gauteh/omb-nano/(threads)

Thread 1 (2024-05-23):

GPS: power off on EINT

gauteh, 2024-05-23:
* https://github.com/sparkfun/SparkFun_u-blox_GNSS_Arduino_Library/blob/main/examples/Example22_PowerOff/Example22_PowerOff.ino
* https://learn.sparkfun.com/tutorials/gnss-receiver-breakout---max-m10s-qwiic-hookup-guide

gauteh, 2024-08-06:
I'm seeing around 24 mA @ 5V when logging IMU. Seems a bit high to me? I guess I will see the low when the IMU is done sampling and it goes to sleep, would be helpful if the IMU sample window could be decreased to e.g. 30 seconds for in the test-mode.

gauteh, 2024-08-06:
```
content: 0x47 | 0x1 | 0x46 | 0x5E | 0x16 | 0xB2 | 0x66 | 0xAB | 0xCF | 0xFD | 0x23 | 0x8E | 0x83 | 0x2D | 0x3 | 0x45 |
Rock7 format content: 4701465E16B266ABCFFD238E832D0345
--------------------
turn gnss off
putting gps to sleep.
Attempting to put gps to sleep
gnss wire started
success starting GNSS
gps sleeping...
gps sleeping.
success.
turn iridium on
turn gnss off
putting gps to sleep.
Attempting to put gps to sleep
gnss wire started
success starting GNSS
gps sleeping...
gps sleeping.
success.
Calling internalBegin
IridiumSBD::beginSerialPort
>> AT
Waiting for response OK

```

gauteh, 2024-08-06:
Yes, that is what I'm trying to get them to do :)

gauteh, 2024-08-06:
Pretty sure it's the GPS, because unplugging the LiIon on the rockblock does not change the current draw.

gauteh, 2024-08-06:
Relevant code is here: https://github.com/gauteh/omb-2024-nano/blob/main/src/gnss_manager.cpp#L7

gauteh, 2024-08-06:
> the change is to hard code taking just a few imu measurements:
>
> https://github.com/jerabaul29/OpenMetBuoy-v2021a/blob/129916e1e05f97facc37a9b5c94781a2f2e4fec0/legacy_firmware/firmware/functionality_test_mode/wave_analyzer.cpp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

Thanks, I have to do this, since lots of ports and pins are changed from original OMB.

gauteh, 2024-08-06:
Can't unplug the GNSS, its mounted on board.

gauteh, 2024-08-06:
Are the measurements above with the power led on?

gauteh, 2024-08-06:
I think that will destroy the board, I should probably just try this: https://github.com/sparkfun/SparkFun_u-blox_GNSS_Arduino_Library/blob/main/examples/Example22_PowerOff/Example22_PowerOff.ino

gauteh, 2024-08-06:
Yes, good point. I can remove the Artemis to test that. There are also some broken artemises, that use much more power.

gauteh, 2024-08-07:
https://github.com/sparkfun/SparkFun_u-blox_GNSS_Arduino_Library/issues/228

gauteh, 2024-08-28:
If this dosen't work we need to add some on/off circuit.

gauteh, 2024-08-29:
Maybe @zerblatt007 has the chance to help us set up the MOSFET circuit, here's the schematic from SparkFun: https://cdn.sparkfun.com/assets/f/4/5/3/4/SparkFun_Artemis_Global_Tracker_SCHEMATIC_v10.pdf ?

zerblatt007, 2024-08-30:
GPS power switch should be easy enough.. :)

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

zerblatt007, 2024-08-30:
I have inserted the Q1 FET on A16 and updated the PCB, just to see how
things pan out.
This is just more or less dumped on there, so check if it looks ok to you..
There was a new R5 also? And an extra BAT2 ..

fre. 30. aug. 2024 kl. 08:43 skrev Roger Storvik ***@***.***>:

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

gauteh, 2024-08-30:
Nice. Adding the artemis module directly (with USB to serial) would be next on the wishlist ! (should have a JTAG header holes just in case as well).

Closed 2025-03-05.

Thread 8 (2024-05-27):

IMU: power down

gauteh, 2024-05-27:
Is it necessary: what is the current when it is just running?

gauteh, 2024-08-06:
AD31 (A5 on nano) does not seem to be able to drive the power on the IMU, if I short the backup it works. @jerabaul29 do you know how to change the drive-strength in arduino-C?

gauteh, 2024-08-06:
Figured it out:
```

pinMode(IMUPwr, g_AM_HAL_GPIO_OUTPUT_12); // 12 mA

```

gauteh, 2024-08-06:
Yup. Increasing to 12 mA (https://github.com/gauteh/omb-2024-nano/issues/8#issuecomment-2271118244) fixed it. Now trying to put the GNSS to sleep (#1).

Closed 2024-08-06.

Thread 9 (2024-05-29):

points from the discussion

jerabaul29, 2024-05-29:
Thanks for the good discussion @gauteh @askbreivik , and very nice to meet you digitally @askbreivik :) .

The modem you use now is the same I had on:

https://github.com/jerabaul29/LoggerWavesInIce_InSituWithIridium

The PCB schematics are at:

https://github.com/jerabaul29/LoggerWavesInIce_InSituWithIridium/tree/master/PCB_electronics/Logger_and_power_v1

I do not remember how I was giving power to the iridium modem, I wonder if I was just using the 3.3V from the arduino mega, but I may be remembering wrong. The answer should be in the [Logger_and_Power.sch](https://github.com/jerabaul29/LoggerWavesInIce_InSituWithIridium/blob/master/PCB_electronics/Logger_and_power_v1/Logger_and_Power.sch) file (that can be opened with kicad).

Very interesting discussions about power supplies. It may be that my method of having batteries in parallel is a bit suboptimal when using these nice pololu regulators, and that it would be better to put cells in series to get to for example 8-10ish volts, and then use the pololu in step down mode - this looks like this could be more energy efficient and possible to supply more power as you pointed out. Maybe in this case the 3.3V regulator is enough, but as we have discussed it should be easy to put a 5v regulator, and to reduce quiescent current when not in use to switch it off fully with the shdn pin ( https://www.pololu.com/product/2123 ) .

Note that pololu has many regulators, including "old" designs that are much worse than the newer S7V8 series (guess they keep them to supply existing designs :) ), but these more recent S7V8FX regulators are really good :) .

Apololgies for the mess in the OMB code, I have never had the time to clean this up. Let me know if you have any questions. I think that given that the MCU and components are the same, it should be easy to adapt the OMB firmware, with just a few pin number / port number updates as we discussed :) . For the I2C / "Wire" in SF lingua ports, see for example https://github.com/sparkfun/Arduino_Apollo3/blob/v1/libraries/Wire/examples/Example2_MoreI2CPorts/Example2_MoreI2CPorts.ino and adjacent files.

This will be very exciting, looking forward to see how you develop this forward :) .

gauteh, 2025-03-05:
I think we got through most of this. Will continue in separate issues.

Closed 2025-03-05.

Thread 13 (2024-07-29):

Next PCB

gauteh, 2024-07-29:
- [x] Correct space between pins for RockBlock
- [x] More parallel battery-terminals
- [x] Use ambiq module
- [x] transistor for toggling GPS power (@zerblatt007 ) (#1 )
- [x] usb to serial for ambiq module
- [x] pull-down resistor for iridium-off (#14 )

zerblatt007, 2024-09-10:
Do we have any preference on usb to serial chip (for ambiq module)?

tir. 10. sep. 2024 kl. 13:08 skrev Gaute Hope ***@***.***>:

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

zerblatt007, 2024-09-10:
Makes sense to use that one, yes..

Roger

tir. 10. sep. 2024 kl. 15:45 skrev Gaute Hope ***@***.***>:

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

zerblatt007, 2024-10-25:
Have most of this in schematics form now..
We want the fuse and perhaps a regulator?
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

zerblatt007, 2024-10-25:
Do we need something like this?
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

zerblatt007, 2024-10-25:
My reference is this, but maybe not a good one?
https://cdn.sparkfun.com/assets/5/5/1/6/3/RedBoard-Artemis-Nano.pdf

gauteh, 2024-10-25:
Can we use the pololu regulator that we already have on? We know it works with the modem, and it takes a range from about 2.5V to 11.5V?

zerblatt007, 2024-10-25:
> Can we use the pololu regulator that we already have on? We know it works with the modem, and it takes a range from about 2.5V to 11.5V?

Yes, of course.. It is set for 3.3V?

gauteh, 2024-10-25:
Yes. It's not configurable. Always 3.3V.

zerblatt007, 2024-12-03:
This is the amplifier used on before the GPS antenna: (BGA725L6E6327FTSA1) https://www.infineon.com/dgdl/BGA725L6_V2+0.pdf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

It is controlled with the VACT_GPS_OUT on sfy and now maybe on the OMB-nano (U21)

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

Could it be that this pin is not controlled correctly on sfy and the reason for no GPS success?
Will there be a problem controlling it on the OMB-nano?

zerblatt007, 2024-12-03:
"Correct space between pins for RockBlock"
I have problems finding the correct footprint for RockBlock 9602 (9603 seems to be the replacement and has a different connector?)
So to use the 9602 we need to make a new footprint or line up 2 headers. But what is the correct distance between pin 6 and 8 (on the old schematics. I have a new symbol loaded, but the footprint is like the old one, just the symbol is changed..

gauteh, 2024-12-03:
Here are the docs for the 9602: https://docs.groundcontrol.com/iot/rockblock/specification/dimensions, the 9603 has a trickier connector. There are some CAD models there, but I don't know if they include the pins.

I _thought_ that the antenna was not active, but I'm not sure. It seems the SFY/notecard is supposed to always supply VACT_GPS_OUT, but maybe we need to connect VACT_GPS_IN to it: https://dev.blues.io/datasheets/notecard-datasheet/note-nbgln/#active-gps ? I don't see any hardware way to control this, but maybe there's an inductor that allows both active and passive to be connected? Or the middle pin in the U.FL. connector may not be used on passive GPS antennas.

gauteh, 2024-12-03:
> The AGT uses the 9603, and all the schematics and Eagle files should be here: https://www.sparkfun.com/products/18712 under the "Documents" tab :) .

I was thinking that we should try to get it to work on the 9602 first, since they have the same driver and same operating modes. But the 9602 has a much easier pin interface to develop with. I'm not completely sure what makes 9603 better?

We are building 10 OMB's for UiB in the early spring, maybe we can use this version then.

gauteh, 2024-12-03:
> I have problems finding the correct footprint for RockBlock 9602 (9603 seems to be the replacement and has a different connector?)

Actually, if this saves time to do right away we could go straight for the 9603?

gauteh, 2024-12-03:
> Depends on how many 9602 modules we have in stock? They are expensive?

We only have one now. I can order a 9603 if we go for that one. Plus we may have a few 9603's from broken OMB's that we can salvage.

zerblatt007, 2024-12-03:
Cable is probably a good idea, so things won't rattle apart, so then we need to find a suitable 10p socket for the PCB and a cable length of like 4cm (female-female)?
This is Molex 51021 10p, but this is not for PCB mount?:
https://no.mouser.com/ProductDetail/Molex/51021-1000?qs=zXrbR4Jv0OdnHhceUiV3oQ%3D%3D

gauteh, 2025-02-27:
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

Closed 2025-02-28.

Thread 14 (2024-08-13):

Iridium: power-down

gauteh, 2024-08-13:
I have On/Off connected to A14 on Artemis Nano (AD35). It seems to turn the modem off and on, and holds the voltage low. But when the whole board powers down it seems to return to floating voltage.. thus powering the modem back on.

gauteh, 2024-08-13:
Yes, that is a good idea.

tir. 13. aug. 2024, 12:50 skrev JR ***@***.***>:

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

Closed 2025-02-28.

Thread 15 (2025-02-28):

Next PCB (from v1.4)

gauteh, 2025-02-28:
- [x] Swap polarity on Iridium CN1 connector
- [x] fix transistor
- [x] leave vio_sel floating
- [x] regulator for ch340? not sure if this is necessary, not used on sparkfun AGT (is probably off when no usb connected)
- [x] indicator led
- [ ] pull-up on sda/scl to gps?
- [x] gps_wake triggers reset of ambiq?
- [x] magnet seems to be inverted.

Ref https://github.com/gauteh/omb-2024-nano/issues/13

gauteh, 2025-02-28:
Possibly swapped transistor:

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

gauteh, 2025-03-03:
Tried to solder above the GPS and to VCC on r14 and transistor. This resulted in the serial to reset and restart every time I opened a serial connection. R14 is connected to rts on serial and reset on ambiq, so it's likely something went wrong there... Couldn't find any issues with the multimeter though. Might be worth starting from scratch.

gauteh, 2025-03-03:
Maybe it is resetting itself when turning on the gps? 😊

gauteh, 2025-03-04:
When I don't toggle the GPS_WAKE pin (D38 on ambiq) the ambiq doesn't reset anymore... don't know why.

gauteh, 2025-03-04:
It used to be, but may have cut it in trying to mod the PCB.

gauteh, 2025-03-05:
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

I think you got it right @zerblatt007! did you flip r6 as well?

gauteh, 2025-03-05:
Current use @ 3.3V:

GPS fixing: 25 mA
Iridium charging: 250 mA (can go up to 500 mA)
Iridium operation: 70 - 250 mA
IMU collection: 12-13 mA

power-down: 13 mA (possibly due to usb-to-serial?)

gauteh, 2025-03-05:
Maybe it's possible to put it in usb-suspend:

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

gauteh, 2025-03-06:
I added a power indicator:

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

@zerblatt007 : could you check if it is correct?

gauteh, 2025-03-06:
So the regulator on the CH340 is now mainly to ensure that it is off when no USB is connected? A bit risky to add another regulator now?

zerblatt007, 2025-03-06:
> So the regulator on the CH340 is now mainly to ensure that it is off when no USB is connected? A bit risky to add another regulator now?

Hehe, it is not a very complicated circuit, but any change could lead to something unknown, that is true.

We could perhaps have done this without any capacitors as this is only to be used in the lab, but maybe we would like more there later..

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

zerblatt007, 2025-03-06:
Maybe this would do?

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

gauteh, 2025-03-07:
ordered!

Closed 2025-03-07.

Thread 16 (2025-03-05):

No iridium messages coming through

gauteh, 2025-03-05:
Put the buoy out for testing on the roof an hour ago. No messages coming through yet. Verified there was power on vout.

* Possibly try with the usual antenna
* Not sure if the onboard antenna works, this would perhaps prevent it from attempting iridium transmission?
* Wait for better weather so I can debug outside...

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

zerblatt007, 2025-03-05:
Not related to Iridium, but I think the GPS would not work as R32 is cut on that board now.

gauteh, 2025-03-05:
That could be the reason. I think the buoy goes into hibernation if it doesn't get a gps signal.

zerblatt007, 2025-03-05:
Then I suggest connecting a GPS antenna tomorrow and if then everything works, we try to replace R23 to see of the onboard GPS antenna works..

gauteh, 2025-03-05:
Ok, good plan.

gauteh, 2025-03-06:
Swapped with flex-antenna, and now it works, even in my office.

gauteh, 2025-03-06:
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

Also a good option. I have pretty good experiences with the super-cheap flex antennas as well.

Closed 2025-03-06.

Thread 19 (2025-03-06):

Next PCB (from v1.5)

gauteh, 2025-03-06:
Ref #15

- [x] Consider removing jumper for VBAT / VUSB.
- [x] More holes for fastening modem.
- [x] rf tune? #20
- [x] Increase diameter on battery-terminal holes, difficult to solder currently.
- [x] [ambiq doesn't start when on battery power #22](https://github.com/gauteh/omb-nano/issues/22)
- [x] smaller power led?

zerblatt007, 2025-03-06:
We could do the diode trick from SFY3, there is a lot of space so should be easy..

zerblatt007, 2025-03-06:
But it will use some power..

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

gauteh, 2025-03-25:
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

Now running window of my office (also with GPS signal..). 4.83V, single 1x3 D-cells (Japcell).

zerblatt007, 2025-03-27:
Should we check if those battery connectors have a PCB mount option?
If there are, we could get them pre mounted?
What is the name of the black connectors we solder on?

gauteh, 2025-03-27:
> What is the name of the black connectors we solder on?

https://www.sparkfun.com/led-strip-pigtail-connector-2-pin.html

Closed 2025-05-20.

Thread 20 (2025-03-06):

question about impedance tuning of RF traces

jerabaul29, 2025-03-06:
I am trying to understand a bit more around impedance tuning of RF traces. Usually these need to be 50 Ohm with quite good accuracy to avoid signal reflection and distortions, and it is quite easy to mess this up and to get reflections etc. References for JLCPCB:

- https://jlcpcb.com/blog/understanding-impedance-matching-for-high-speed-pcb-designs
- https://jlcpcb.com/help/article/User-Guide-to-the-JLCPCB-Impedance-Calculator
- https://jlcpcb.com/pcb-impedance-calculator

Only RF traces should be sensitive to this - this means, signal from antennas to the chips pins (GPS / iridium / GSM etc). For our "slow" I2C and similar signals, this should not really play a role.

- If I understand correctly, this is not an issue for iridium, since either the patch antenna or the SMA connector on the rockblock module is used, and these modules are well tuned to start with :)
- So this lets the GPS antenna track. For now https://github.com/gauteh/omb-nano/issues/15#issuecomment-2700256282 it looks like this is routed on the PCB? Then this specific one trace from the ANT GPS pin to the antenna would be sensitive to tuning?

A few questions about these GPS signal tracks @zerblatt007 :

- is the board designed as a 2-layer standard PCB from JLCPCB? If so, it looks like their online calculator does not "accept" to provide microstrip ampedance tuning references? There are quite some discussions on the internet, see e.g. https://electronics.stackexchange.com/questions/731842/how-to-match-50-ohm-impedance-on-2-layer-pcb or https://electronics.stackexchange.com/questions/669162/unexpected-low-characteristic-impedance-using-the-jlcpcb-impedance-calculator and similar, that the traces with 2-layer PCB need to be so wide in microstrip configuration that it is not practically convenient (and that there are edge effects close to the pins that will induce impedance mismatch there). Or is the PCB 4-layer and this is not an issue?
- if this is a 2-layer PCB, it looks like a coplanar impedance tuning design should be ok to do, but this requires having the signal trace "immersed" in a well grounded (many vias to the bottom gnd plate) area, with specific gaps to the grounded area

Do you have more information about how you did the impedance tuning for the GPS antenna traces? Would be very curious to hear about this.

As a note, a possible way around for the GPS could be to use e.g. the ublox M10Q module https://www.u-blox.com/en/product/sam-m10q-module , as it comes with the patch antenna included, so there is no need to have any RF trace on the PCB then - that would be the same method as with the iridium modem board :) .

gauteh, 2025-03-06:
I think this is the one we have: https://ignion.io/product/duo-mxtend/, they do have a tuning program, but it seems to produce the same circuit no matter and apart from that they give some guide lines about clearance around the antenna.

zerblatt007, 2025-03-06:
We did not really try to optimize this, the priority was to make it work this time around.
The board is a 2 layer, but we do not really need to have these long wires to the RF connector, so to optimize we can perhaps move it closer to the chip and perhaps remove the "active antenna" filter if it is not needed.

I also have a el-cheapo VNA "N1201SA 140MHz-2.7GHz" we could try to connect to see if the circuit is optimal..
It was helpful making Lora antennas at least..

Closed 2025-04-03.

Thread 21 (2025-03-24):

blink power led on start up

gauteh, 2025-03-24:

gauteh, 2025-03-24:
@jerabaul29 I see that the led is on the whole time when the gps is searching. this is expected? maybe too excessive?

zerblatt007, 2025-03-24:
Yes, we did. Sinking is good practice when chip allows it. Same as on the rx/tx for USB chip.

Closed 2025-03-24.

Thread 22 (2025-03-25):

ambiq doesn't start when on battery power

gauteh, 2025-03-25:
* measure 1.25 on ch340 out when no usb connected
* attaching USB cable and connecting with tty starts the ambiq
* cutting power to ch340 (from V_CH340 out on usb-regulator) makes battery power work.

gauteh, 2025-03-25:
* test if adding 10k resistor from v_ch340 to GND helps.

zerblatt007, 2025-04-01:
10K resistor did not help, but replacing AMS1117 with HT7333-1 did.
It has been replaced on v1.6 together with bigger battery terminals.

gauteh, 2025-04-01:
Great! Looks like we are approaching yet another version :) Do you want to make some changes to the antenna as well before doing a new round?

zerblatt007, 2025-04-02:
Yes, I was thinking I had a conversation with opinions with the antenna supplier, but maybe not..
So I should just move the edges a bit as they propose and we try again, I suppose..

zerblatt007, 2025-04-02:
I have adjusted this a bit and poured GND on the top layer as Ignion suggested.
Hope that helps, so what we miss is more holes for strips?

gauteh, 2025-04-03:
Yes, see https://github.com/gauteh/omb-nano/issues/19.

Closed 2025-04-03.

Thread 23 (2025-06-29):

Next PCB

gauteh, 2025-06-29:
- [ ] Active ANT?

zerblatt007, 2025-06-30:
What is the question with Active Ant?
If we should remove the resistor or remove the whole circuit around it?
(and connect GNSS receiver directly to the PCB antenna?)
