gauteh/omb-nano/hardware/SCH_Schematic1_7_2026-02-09.pdf

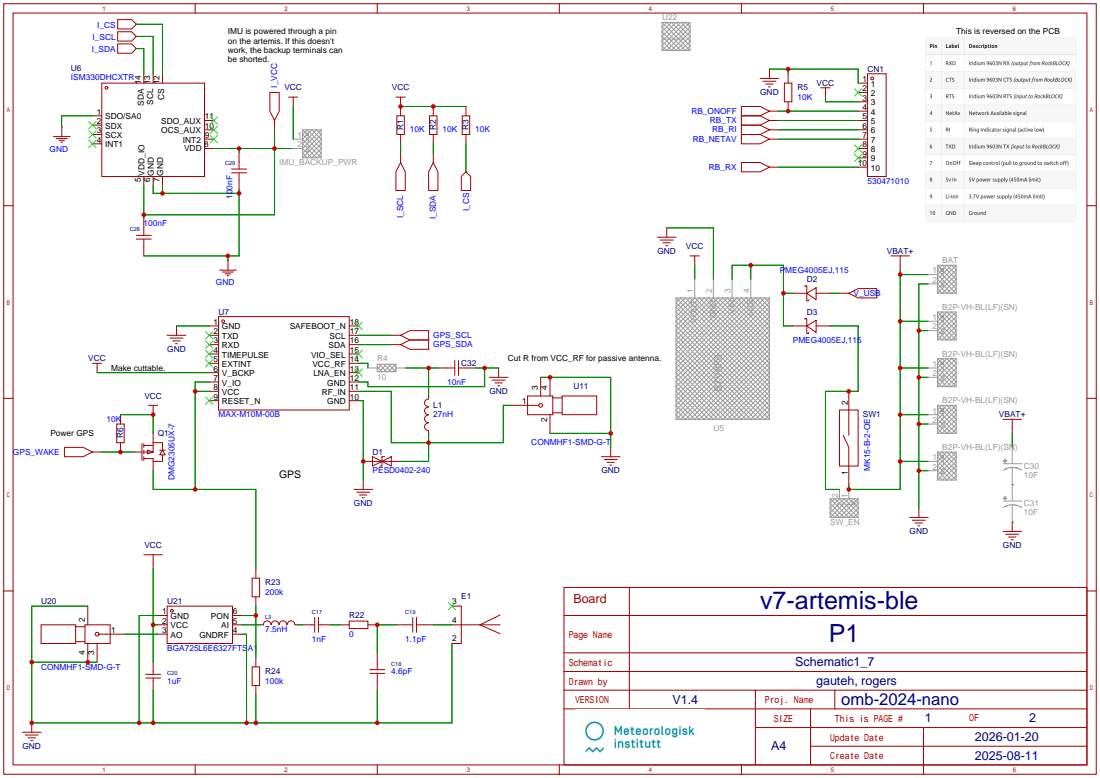
[picture p2: page 1]

IMU is powered through a pin
on the artemis. If this doesn't
work, the backup terminals can
be shorted.

This is reversed on the PCB

Cut R from VCC_RF for passive antenna.

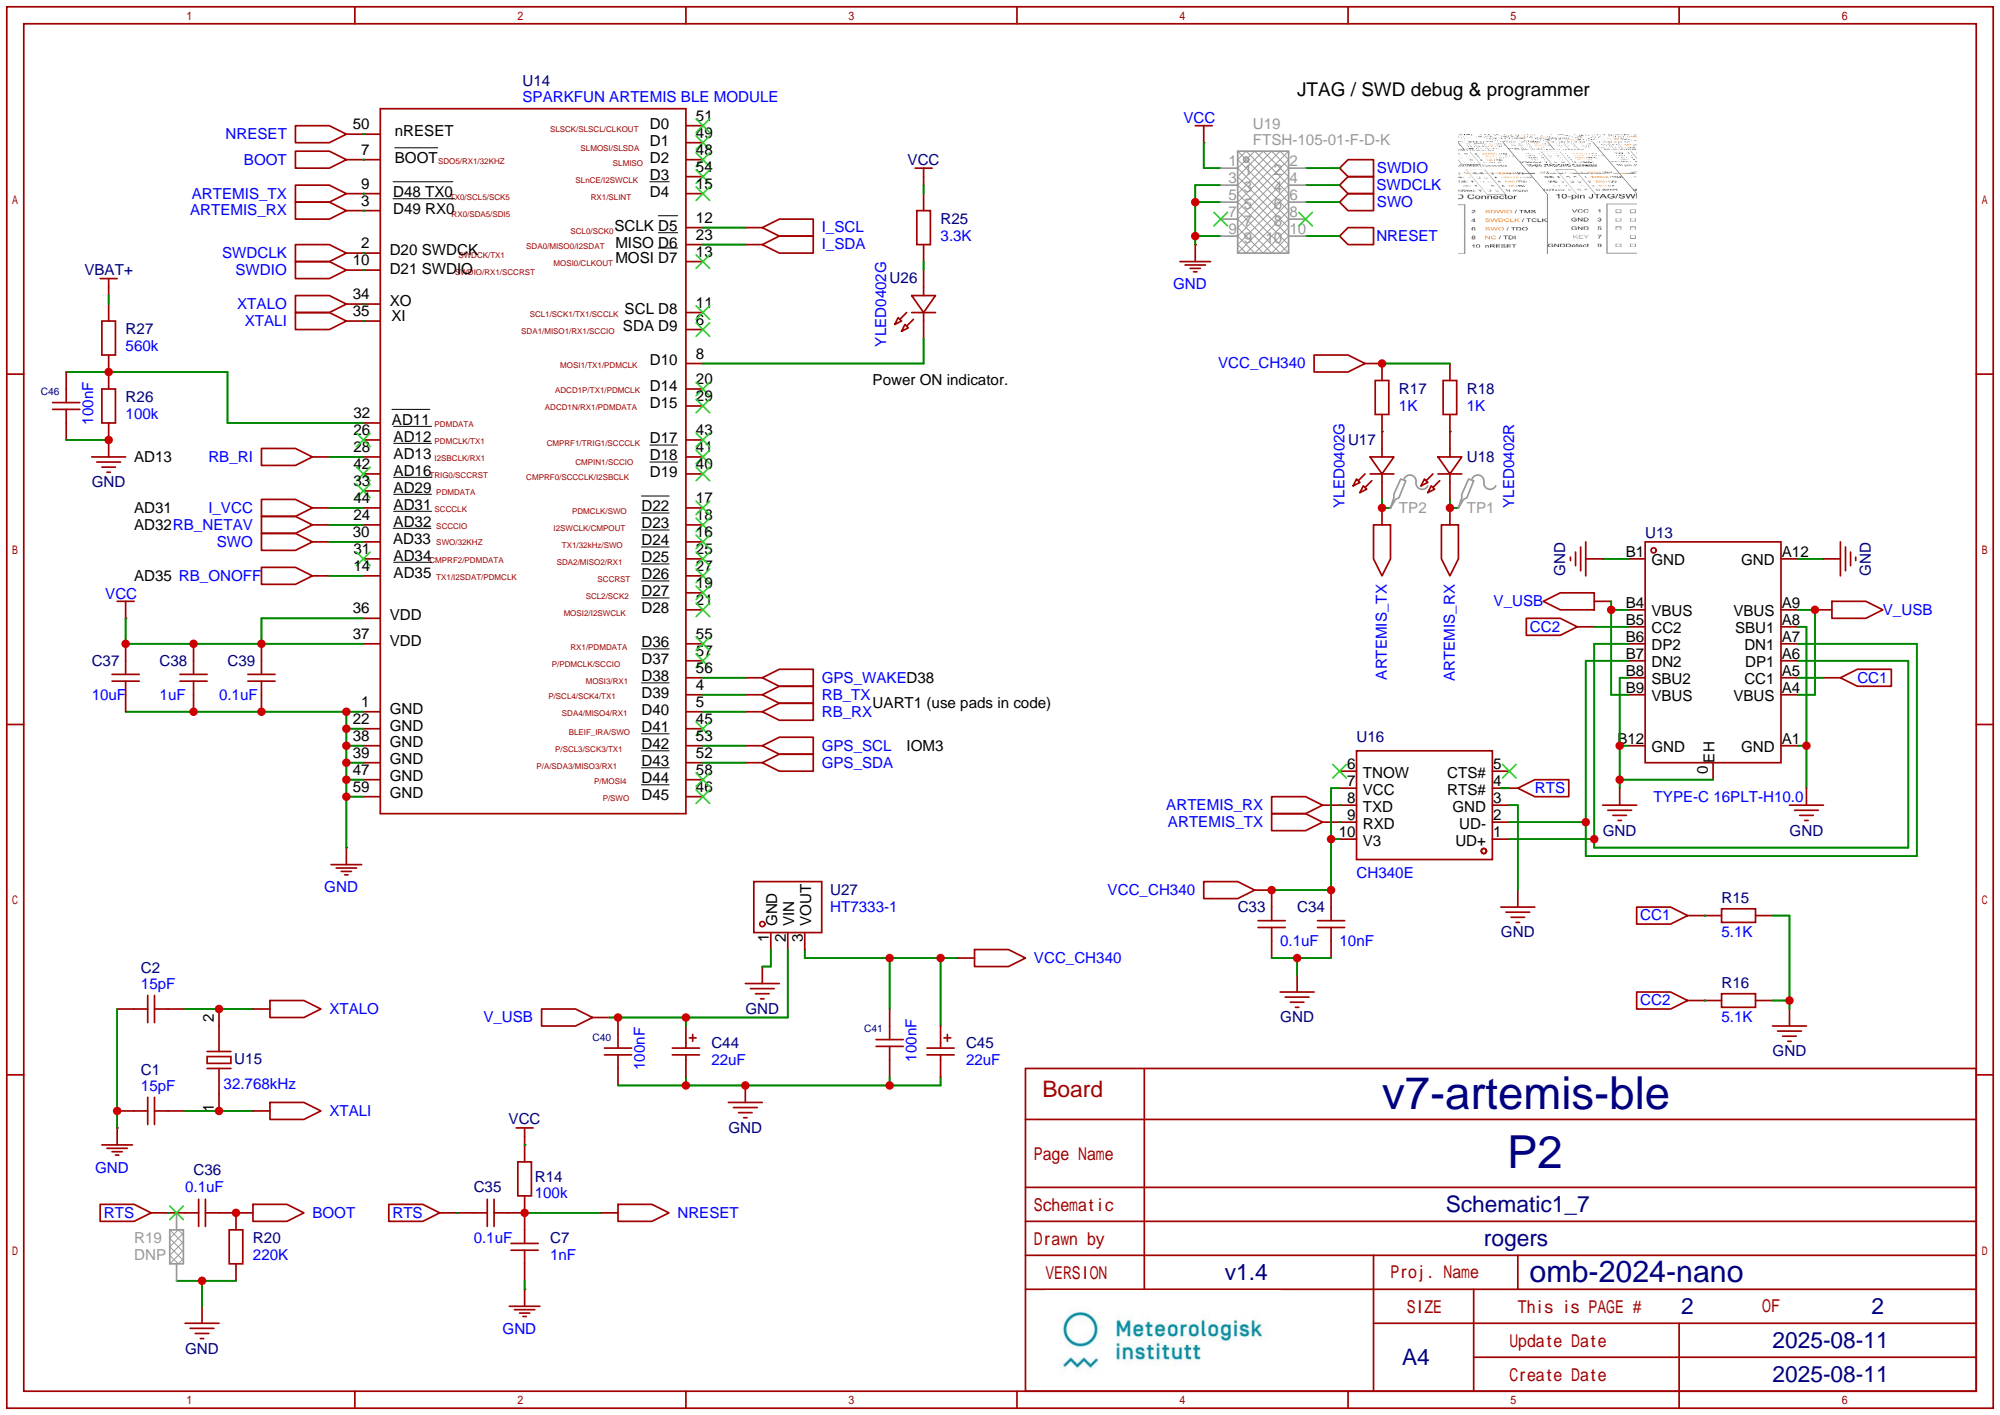
[picture p3: page 2]

SPARKFUN ARTEMIS BLE MODULE
