gauteh/omb-nano/(list of files, drawings)

Other design files:
hardware/ProPrj_omb-2024-nano_2026-02-09.epro
