gauteh/omb-nano/(commit log)

2025-03-24 fix #21: blink power led on start up
    [board_control.h]
2025-03-24 flip led polarity, reduce current: #21
    [board_control.cpp, imu_manager.cpp, sleep_manager.cpp]
2026-01-16 print fw version
2026-01-16 add pcb photo
